ReflexCreations/dance-pad-v3/electronics/padbus-terminator-board/readme.md

# RE:Flex Dance Pad V3 - PadBUS Terminator Board

This board is used to terminate the PadBUS network. The primary and final boards use one each.
