ReflexCreations/dance-pad-v3/electronics/horizontal-padbus-board/readme.md

# RE:Flex Dance Pad V3 - Horizontal PadBUS Board

The V3 Horizontal PadBUS Board facilitates communications and power distribution in the vertical direction in a 4-9 panel network.
