ReflexCreations/dance-pad-v3/electronics/vertical-padbus-board/readme.md

# RE:Flex Dance Pad V3 - Vertical PadBUS Board

The V3 Vertical PadBUS Board facilitates communications and power distribution in the vertical direction in a 4-9 panel network.
