ReflexCreations/dance-pad-v3/electronics/padbus-terminator-board/padbus_terminator_outline.dxf

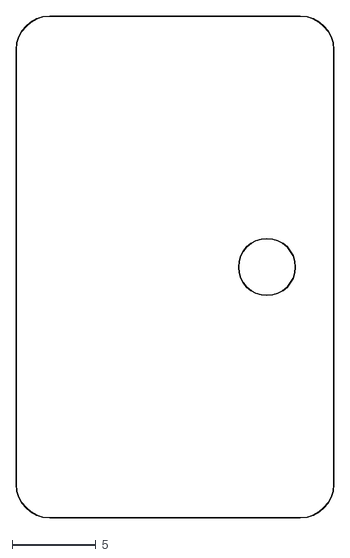
[picture p1: CAD file, 2022-08-02]
electronics/padbus-terminator-board/padbus_terminator_outline.dxf
19.0 x 30.0
