ReflexCreations/dance-pad-v3/electronics/sensor-board/board-outline.dxf

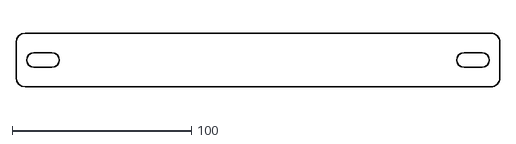
[picture p2: CAD file, 2022-07-01]
electronics/sensor-board/board-outline.dxf
270.0 x 30.0
