ReflexCreations/dance-pad-v3/electronics/horizontal-padbus-board/horizontal_padbus_outline.dxf

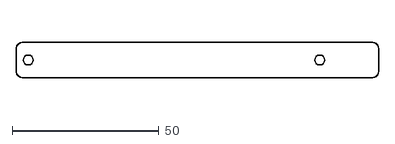
[picture p3: CAD file, 2022-08-02]
electronics/horizontal-padbus-board/horizontal_padbus_outline.dxf
123.4 x 12.0
