ReflexCreations/dance-pad-v3/electronics/panel-board/panel_board_outline.dxf

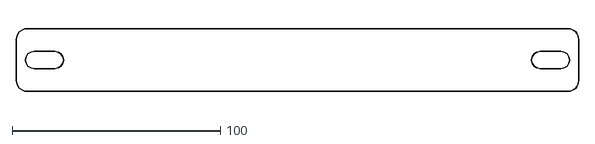
[picture p4: CAD file, 2022-08-02]
electronics/panel-board/panel_board_outline.dxf
270.0 x 30.0
