ReflexCreations/dance-pad-v3/electronics/vertical-padbus-board/vertical_padbus_outline.dxf

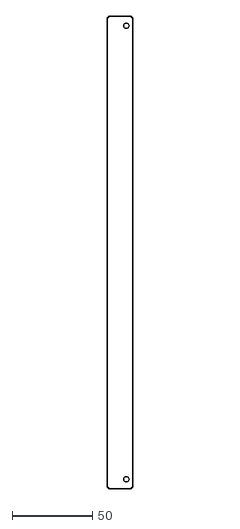
[picture p5: CAD file, 2022-08-02]
electronics/vertical-padbus-board/vertical_padbus_outline.dxf
16.0 x 295.0
