ReflexCreations/dance-pad-v3/(list of files, cad)

Other CAD files:
electronics/horizontal-padbus-board/horizontal_padbus.FCStd
electronics/panel-board/panel_board.FCStd
electronics/vertical-padbus-board/vertical_padbus.FCStd
electronics/padbus-terminator-board/padbus_terminator.FCStd
