ReflexCreations/dance-pad-v3/(commit log)

2022-06-25 Create board outline output
    [sensor_board_dimensions.FCStd]
2022-06-25 Create readme/kicad project
    [sensor-board.kicad_pcb, sensor-board.kicad_sch]
2022-06-26 Build sensor handler / define more pins
    [sensor-board.kicad_sch, sensor_handler.kicad_sch]
2022-06-26 Partial MCU schematic
    [controller.kicad_sch, sensor-board.kicad_sch, sensor_handler.kicad_sch]
2022-06-28 Finish microcontroller design + hierarchy
    [can_bus.kicad_sch, controller.kicad_sch, debug.kicad_sch, led_output.kicad_sch, sensor-board.kicad_sch, sensor_handler.kicad_sch, usb.kicad_sch]
2022-07-01 Upload power supply schematic
    [board-outline.dxf, controller.kicad_sch, power.kicad_sch, sensor-board.kicad_pcb, sensor-board.kicad_sch, usb.kicad_sch]
2022-07-01 Choose output capacitors that won't explode
    [power.kicad_sch, sensor-board.kicad_sch]
2022-07-02 Hopefully finalize power distribution
    [power.kicad_sch, sensor-board.kicad_sch]
2022-07-02 LED output, debug and minor controller changes
    [controller.kicad_sch, debug.kicad_sch, led_output.kicad_sch, pad_bus.kicad_sch, sensor-board.kicad_sch, sensor_handler.kicad_sch]
2022-07-02 Finalize USB
    [sensor-board.kicad_sch, usb.kicad_sch]
2022-07-02 Build Pad Bus and annotate
    [controller.kicad_sch, debug.kicad_sch, led_output.kicad_sch, pad_bus.kicad_sch, power.kicad_sch, sensor-board.kicad_sch, sensor_handler.kicad_sch, usb.kicad_sch]
2022-07-02 Minor tweaks, footprints added
    [controller.kicad_sch, debug.kicad_sch, led_output.kicad_sch, pad_bus.kicad_sch, power.kicad_sch, sensor-board.kicad_pcb, sensor-board.kicad_sch, sensor_handler.kicad_sch]
2022-07-03 Final tweaks and schematic review complete
    [controller.kicad_sch, led_output.kicad_sch, pad_bus.kicad_sch, power.kicad_sch, sensor-board.kicad_pcb, sensor-board.kicad_sch, sensor_handler.kicad_sch]
2022-07-03 Set up board rules w/ controlled impedance
    [controller.kicad_sch, sensor-board.kicad_pcb, sensor-board.kicad_sch, usb.kicad_sch]
2022-07-03 Preliminary sensor layout
    [sensor-board.kicad_pcb]
2022-07-09 Remove DIP switches and re-organize CAN connectors
    [controller.kicad_sch, led_output.kicad_sch, pad_bus.kicad_sch, sensor-board.kicad_pcb, sensor-board.kicad_sch, usb.kicad_sch]
2022-07-09 Update reference designators
    [controller.kicad_sch, debug.kicad_sch, led_output.kicad_sch, pad_bus.kicad_sch, power.kicad_sch, sensor-board.kicad_sch, sensor_handler.kicad_sch, usb.kicad_sch]
2022-07-09 Further PCB layout
    [sensor-board.kicad_pcb, usb.kicad_sch]
2022-07-13 Upgrade to STM32G4 and CAN FD
    [controller.kicad_sch, power.kicad_sch, sensor-board.kicad_pcb, sensor-board.kicad_sch, usb.kicad_sch]
2022-07-15 Switch to G4, preliminary signal layout
    [controller.kicad_sch, led_output.kicad_sch, pad_bus.kicad_sch, sensor-board.kicad_pcb, sensor-board.kicad_sch]
2022-07-16 Finish routing for v3.01
    [power.kicad_sch, sensor-board.kicad_pcb, sensor-board.kicad_sch]
2022-08-02 Update PadBUS standard
    [controller.kicad_sch, debug.kicad_sch, horizontal-padbus-outline.dxf, horizontal_padbus.FCStd, horizontal_padbus.kicad_pcb, horizontal_padbus.kicad_sch, led_output.kicad_sch, pad_bus.kicad_sch]
2022-08-02 Add node termination
    [pad_bus.kicad_sch, panel_board.kicad_pcb, panel_board.kicad_sch]
2022-08-02 Actually update the schematic references
    [pad_bus.kicad_sch, panel_board.kicad_sch]
2022-08-02 Create terminator board
    [horizontal_padbus_outline.dxf, padbus_terminator.FCStd, padbus_terminator.kicad_pcb, padbus_terminator.kicad_sch, padbus_terminator_outline.dxf, panel_board.FCStd, panel_board_outline.dxf, sensor_board.FCStd]
2022-08-02 Point towards the up arrow
    [padbus_terminator.kicad_pcb]
2022-08-07 Pre LED grid changes
    [led_output.kicad_sch, pad_bus.kicad_sch, panel_board.kicad_pcb, panel_board.kicad_sch, sensor_handler.kicad_sch]
2022-08-15 Prelim schematic for FSR+LC gain/adj dig control
    [controller.kicad_sch, led_output.kicad_sch, panel_board.kicad_sch, sensor_handler.kicad_sch]
